jerwah/dell-xps410-j8997-hj485-bay-blanks/PHOTOS.md

# Photos

Back to the [README](README.md).

## The printed parts

Two printed 5.25 inch blanks installed in my XPS 410

Two printed 5.25" blanks installed in my XPS 410.

Two printed 3.5 inch blanks installed: stock on the left, Let it breathe honeycomb on the right

Two printed 3.5" blanks installed: stock on the left, Let it breathe honeycomb (with the more flush face) on the right.

Back view: my printed blank next to the original Dell blank (the one with the sticker), both holding the spare screws

Back view: my print next to the original Dell blank (the one with the sticker), both holding the spare screws.

All three vented blanks: honeycomb and slots installed in the XPS 410 front panel, round holes on the bench

Let it breathe: the honeycomb (top) and slots versions installed in the front panel, the round-hole version on the bench.

## Removing the supports

OrcaSlicer preview of the latch end: keep the latch arms (green), break off the nub under each arm (red) with pliers

Slicer preview of the latch end: keep the latch arms (green), break off the nub under each arm (red).

One pair of needle nose pliers holding the latch arm, a second pair on the nub

One pair of needle nose pliers holding the latch arm, the second pair on the nub.

One nub removed

One nub removed.

Both nubs removed

Both nubs removed.

## The original Dell 5.25" blank (J8997)

These are for shape only; the camera angles make their scale unreliable, so the dimensions in [MEASUREMENTS.md](MEASUREMENTS.md) came from calipers.

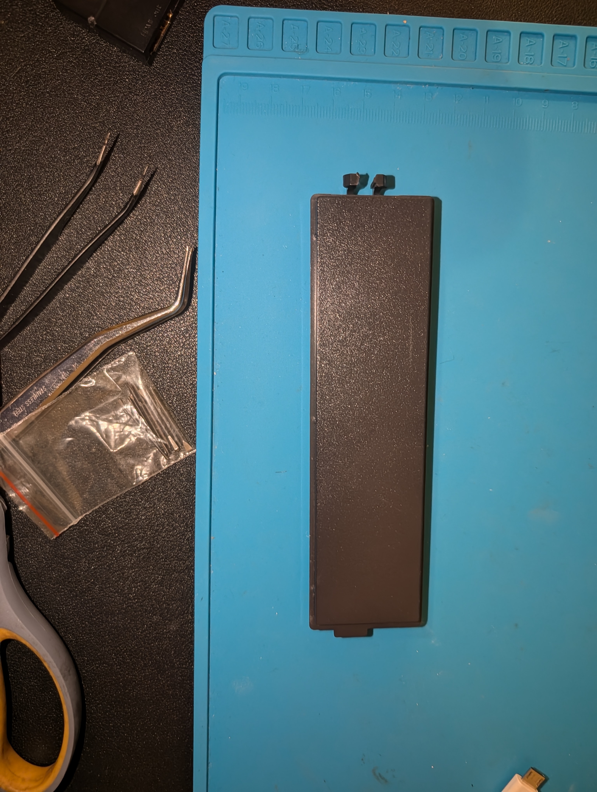
[picture p9: photos/original-front.jpg]
Front face of the original


Front face.

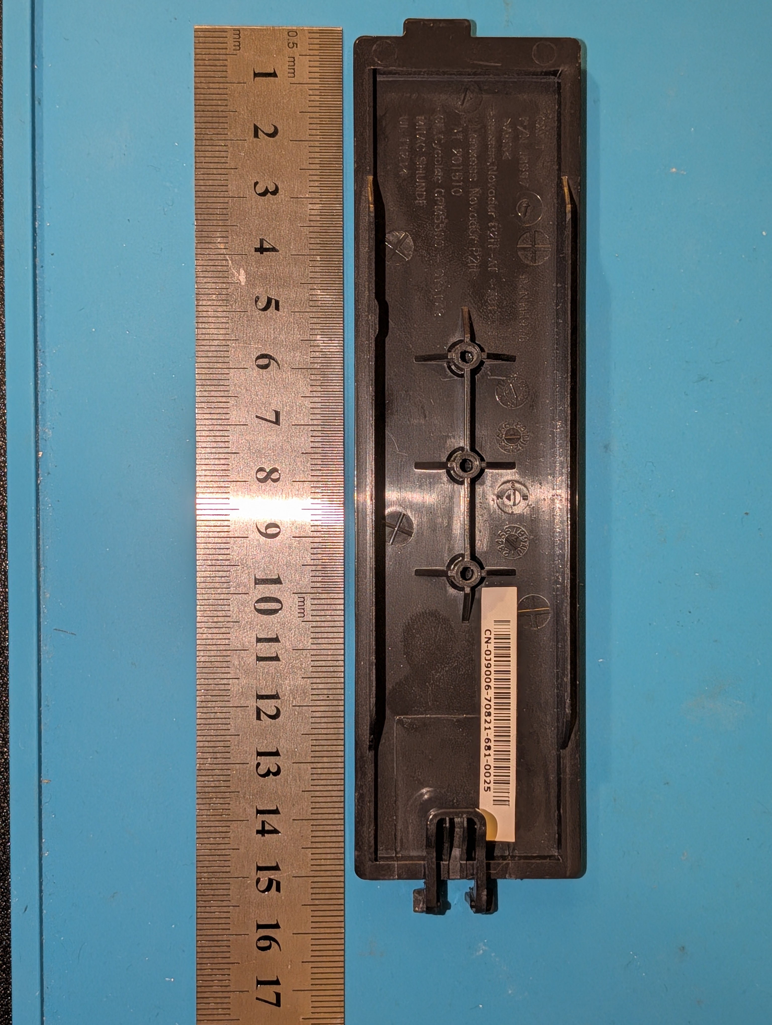
[picture p10: photos/original-back-with-ruler.jpg]
Back of the original with a ruler


Back, with a ruler (best overall view).

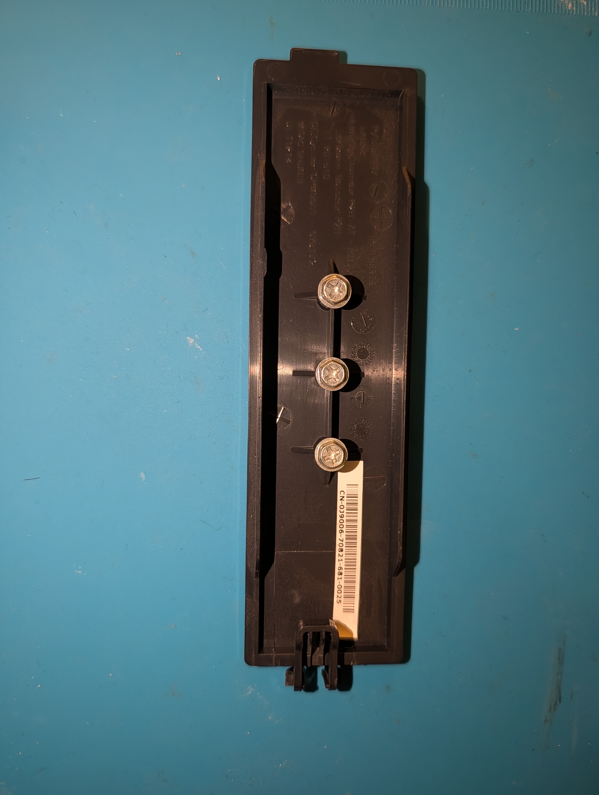
[picture p11: photos/original-back-with-screws.jpg]
Back of the original with the spare screws in the bosses


Back, with the spare screws in the bosses.

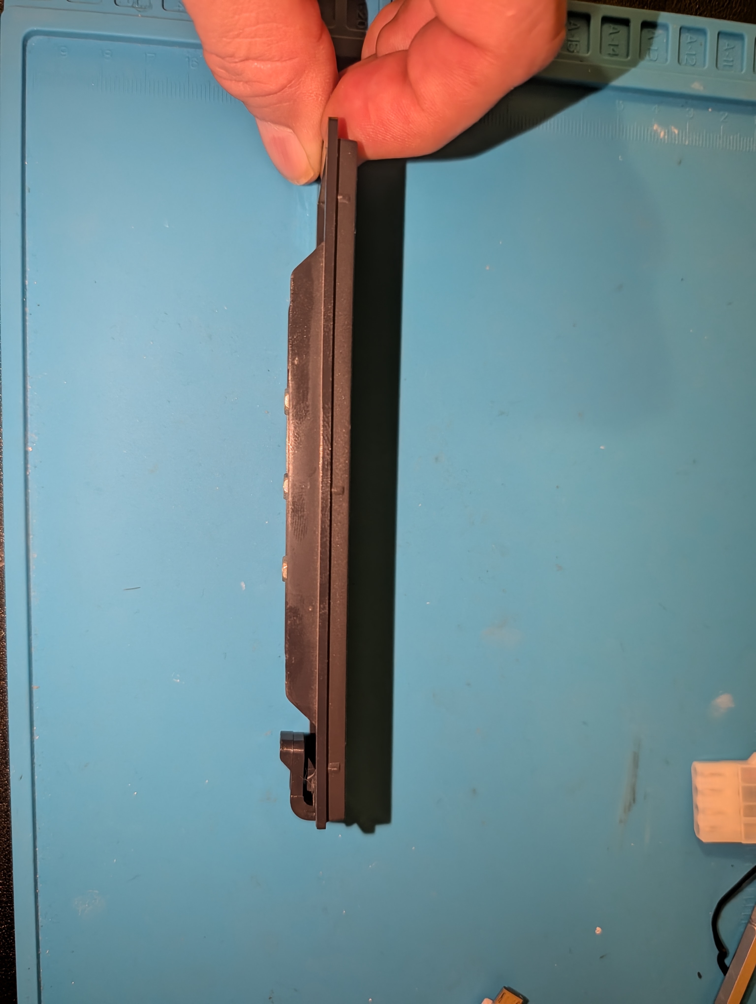
[picture p12: photos/original-side-profile.jpg]
Side profile of the original: rails, ramps and latch


Side profile: rails, ramps and latch.

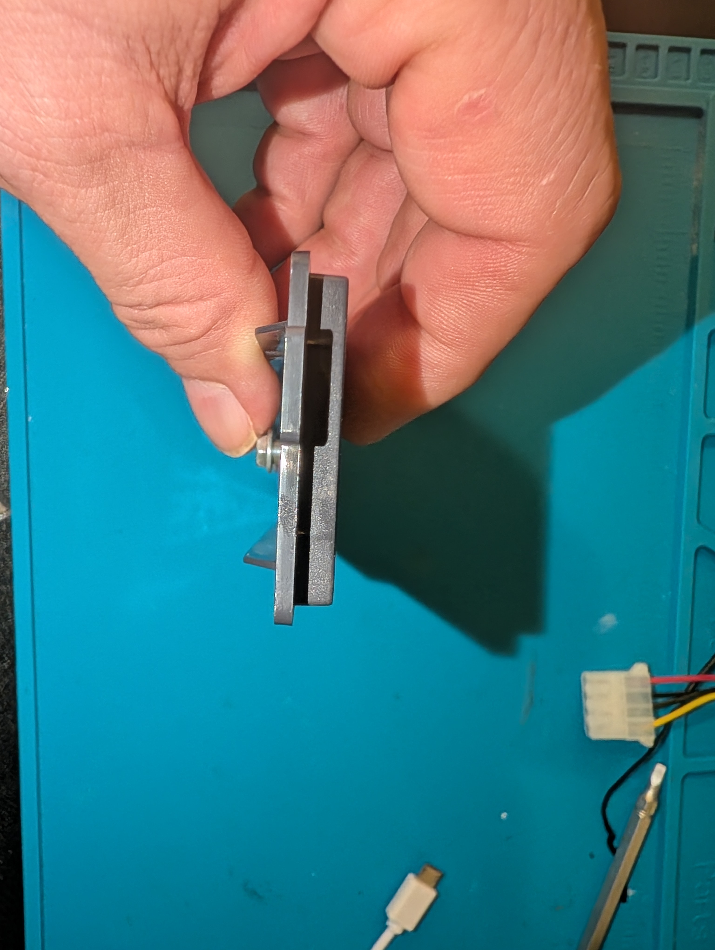
[picture p13: photos/original-end-view.jpg]
End view of the original


End view.

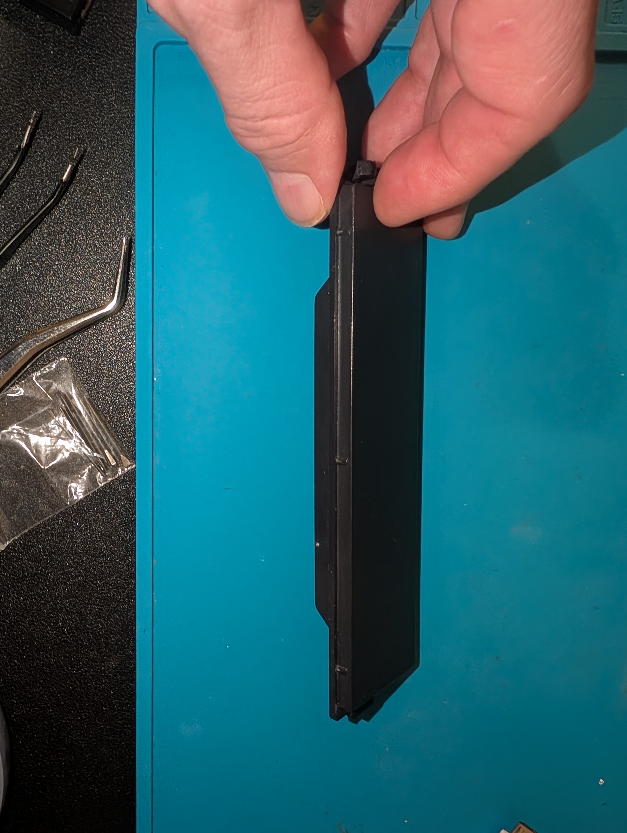
[picture p14: photos/original-edge-crush-nubs.jpg]
Edge view of the original showing the crush nubs


Edge view, showing the crush nubs.

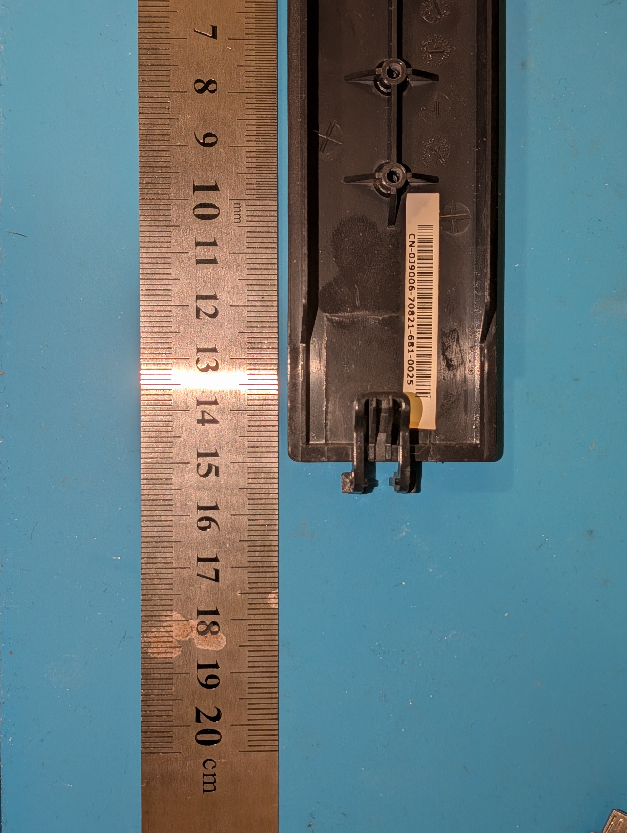
[picture p15: photos/original-latch-back-with-ruler.jpg]
Latch end of the original from the back, with a ruler


Latch end from the back, with a ruler.

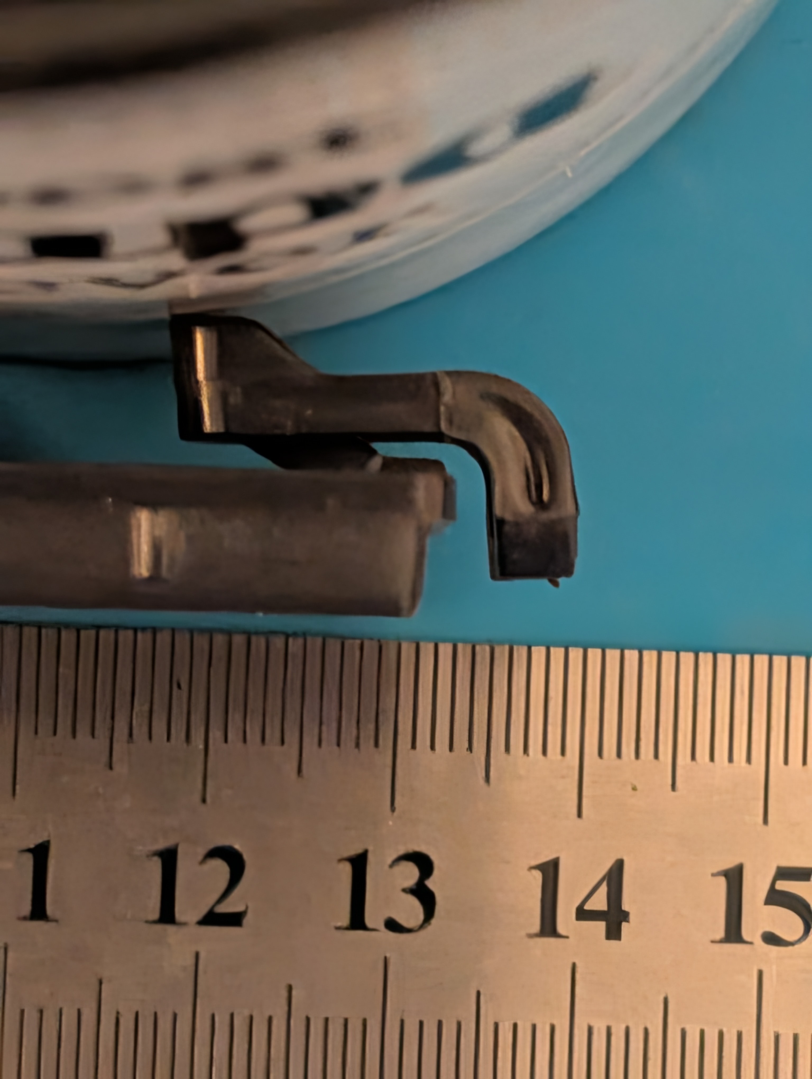
[picture p16: photos/original-latch-side-profile.jpg]
Latch side profile of the original with a ruler


Latch side profile with a ruler (the bend at the end of the arm).

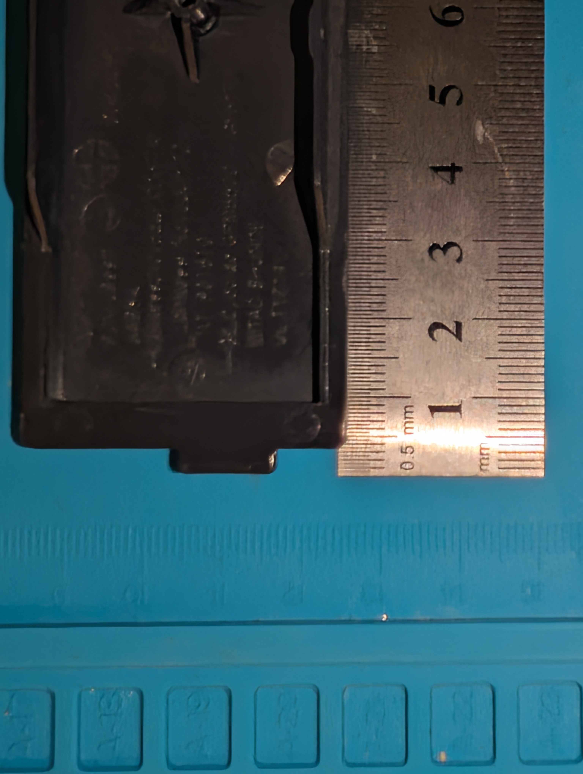
[picture p17: photos/original-tab-closeup.jpg]
Tab close-up of the original with a ruler


Tab close-up with a ruler.

## The original Dell 3.5" blank (HJ485)

As above, for shape only; the dimensions in [MEASUREMENTS-3.5in.md](MEASUREMENTS-3.5in.md) came from calipers.

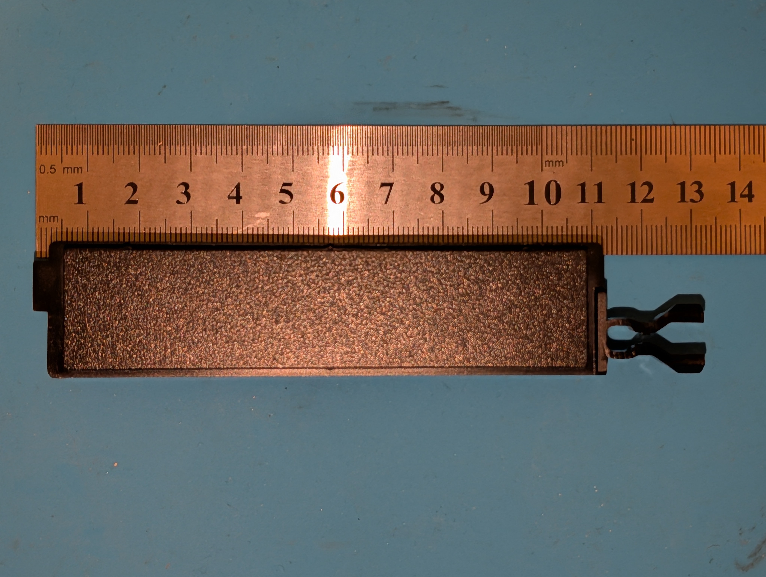
[picture p18: photos/original-3.5-front-with-ruler.jpg]
Front face of the original 3.5 inch blank with a ruler


Front face with a ruler: tab on the left, latch on the right, as installed.

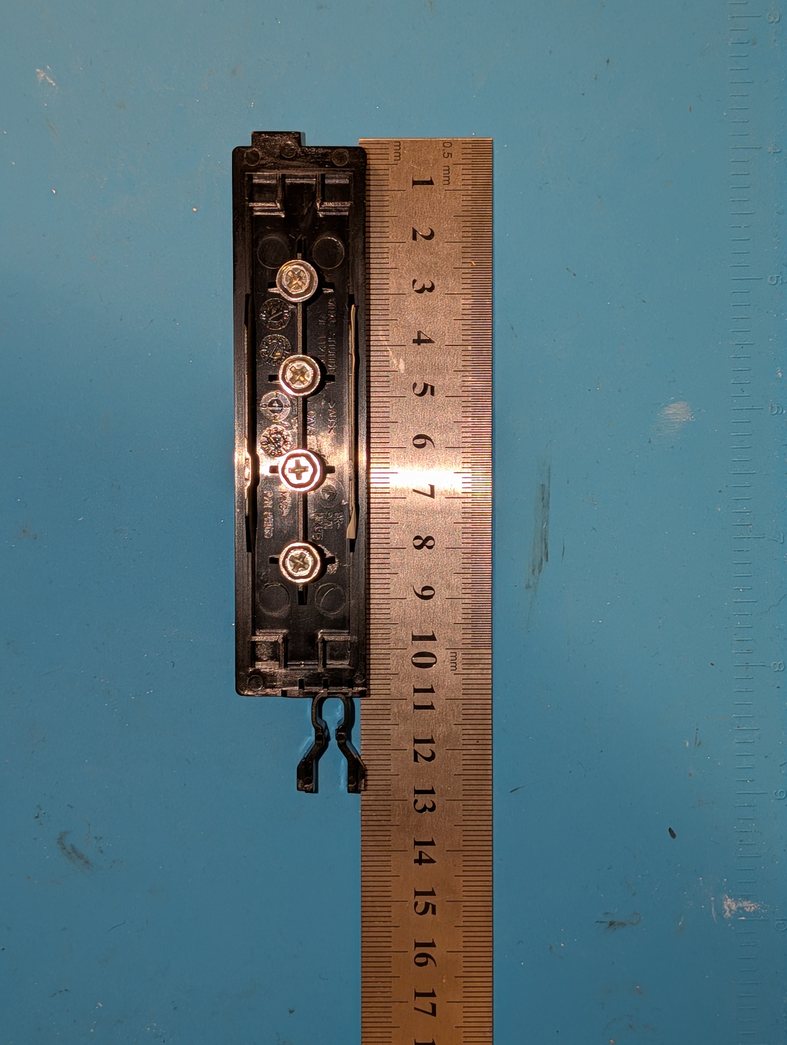
[picture p19: photos/original-3.5-back-with-ruler.jpg]
Back of the original 3.5 inch blank with a ruler


Back, with a ruler (best overall view): pocket, fins, the four screw bosses and the corner boxes.

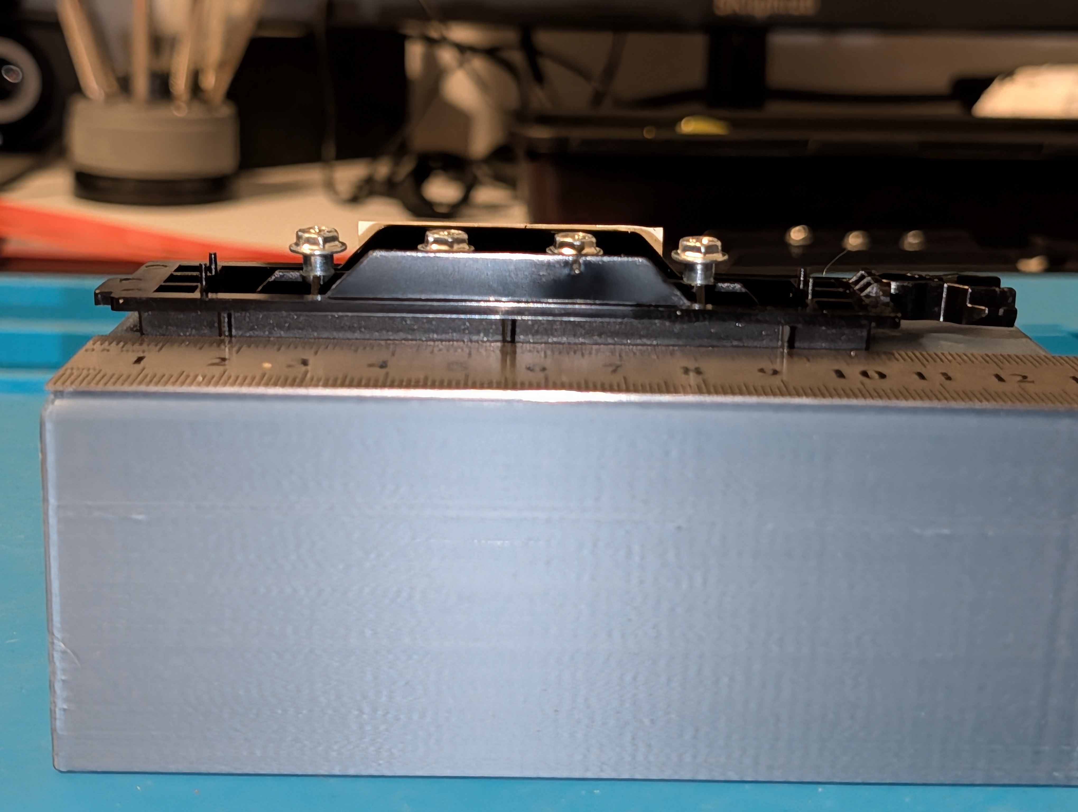
[picture p20: photos/original-3.5-side-profile.jpg]
Side profile of the original 3.5 inch blank


Side profile: the fins and the latch.

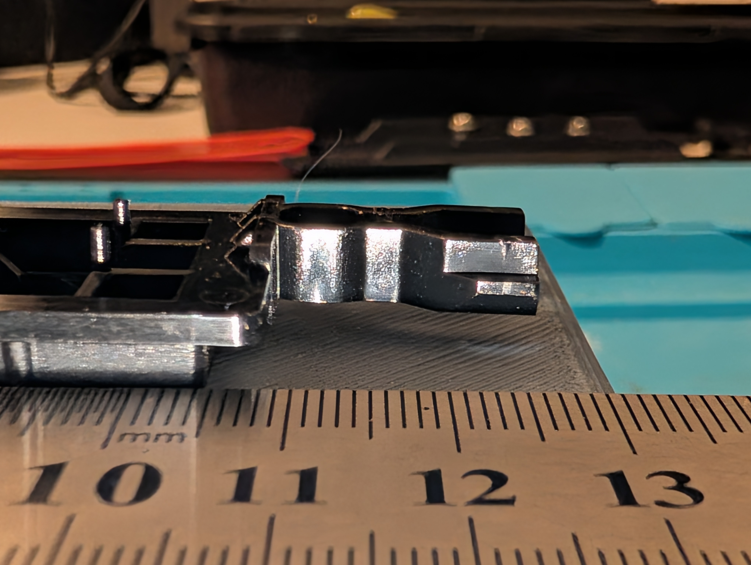
[picture p21: photos/original-3.5-latch-side-closeup.jpg]
Close-up of the original 3.5 inch blank's latch from the side


Latch close-up from the side: the end wall and its braces.

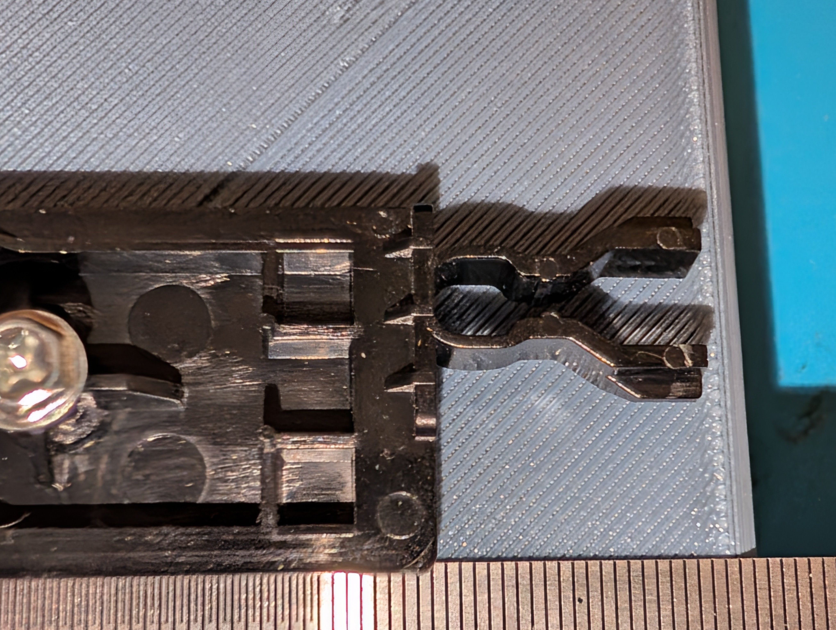
[picture p22: photos/original-3.5-latch-back.jpg]
The original 3.5 inch blank's latch from the back


Latch from the back: the U, the waist, the S-bend and the hooks.

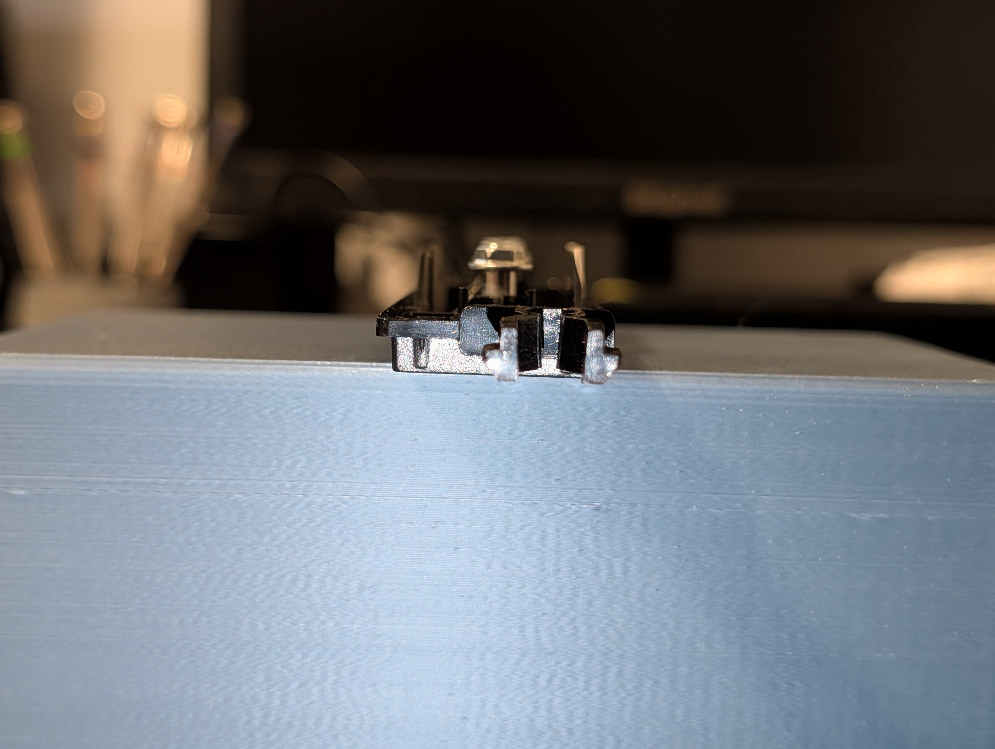
[picture p23: photos/original-3.5-latch-end-view.jpg]
End view of the original 3.5 inch blank's latch, face down


Latch end view, part face down: the hooks' ramps are on the face side.

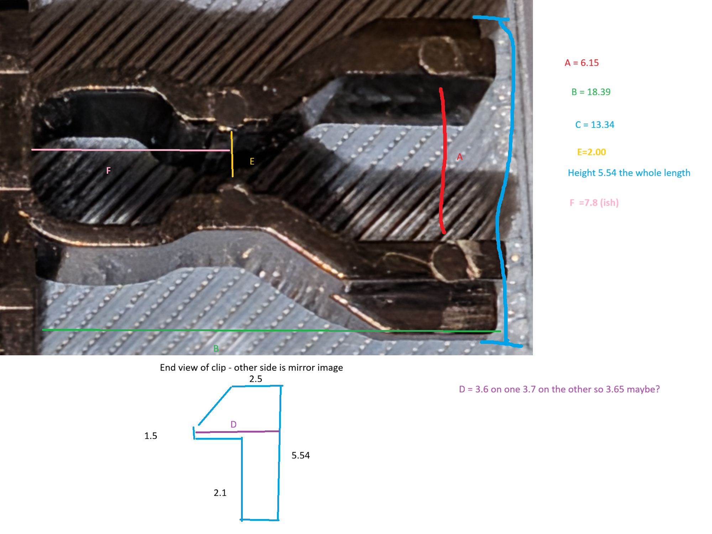
[picture p24: photos/original-3.5-latch-sketch-annotated.png]
My annotated sketch of the 3.5 inch latch


My sketch of the latch with the caliper readings (A to F). The end view sketch is drawn face up, so it's upside down compared with the photo above.

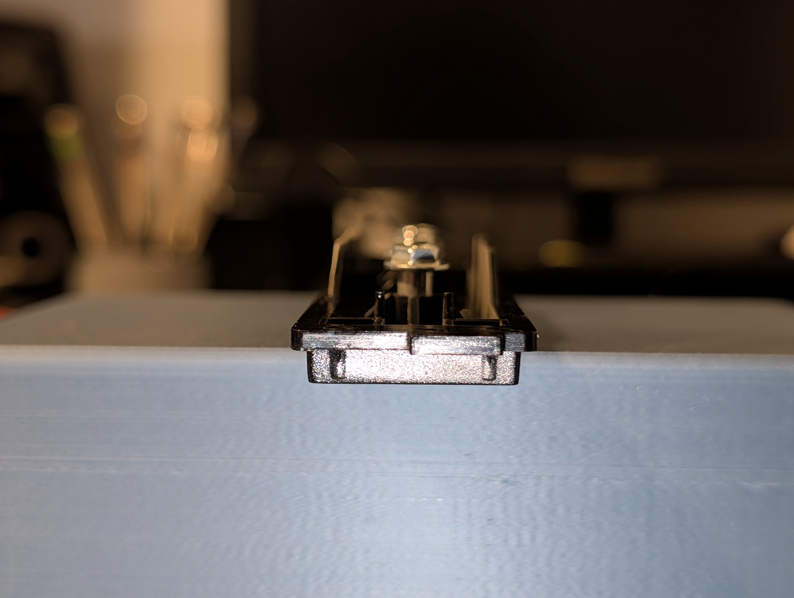
[picture p25: photos/original-3.5-tab-end-view.jpg]
End view of the original 3.5 inch blank at the tab end


Tab end view.

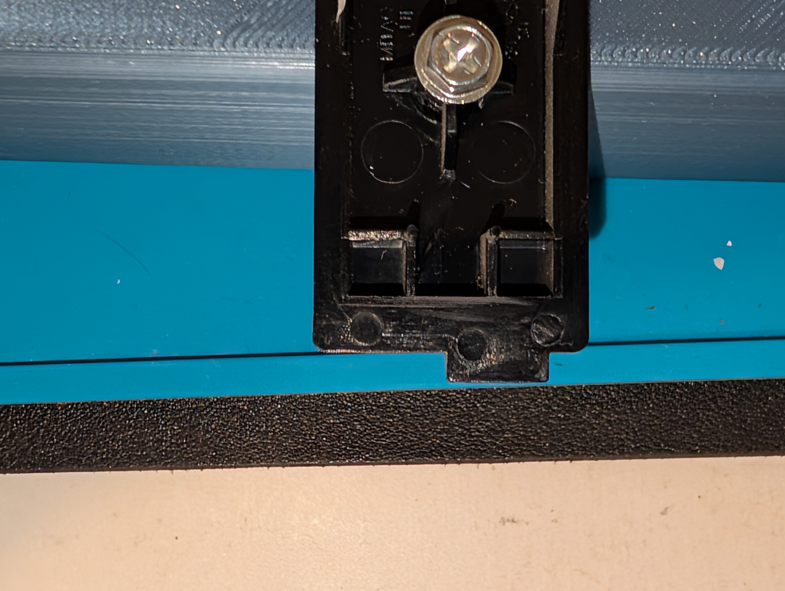
[picture p26: photos/original-3.5-tab-closeup.jpg]
Close-up of the original 3.5 inch blank's tab


Tab close-up.
