jerwah/dell-xps410-j8997-hj485-bay-blanks/stl/test/xps410_3.5_coupon.stl

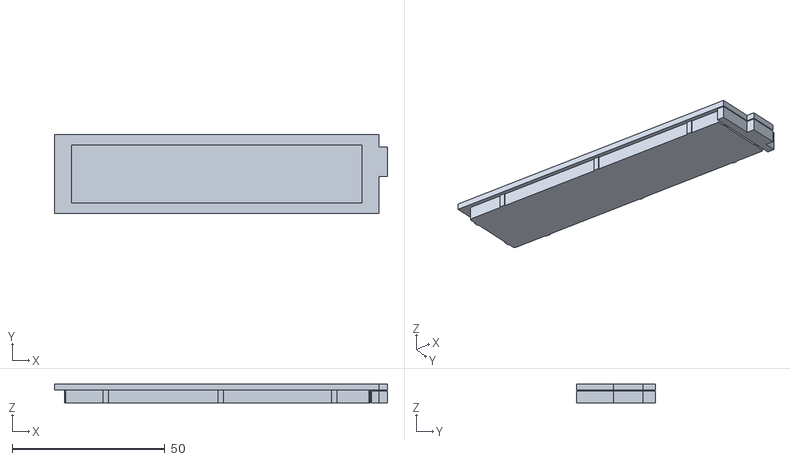
[picture p27: CAD file, 2026-11-12]
stl/test/xps410_3.5_coupon.stl
108.9 x 25.8 x 6.16
