jerwah/dell-xps410-j8997-hj485-bay-blanks/stl/xps410_3.5_bay_blank.stl

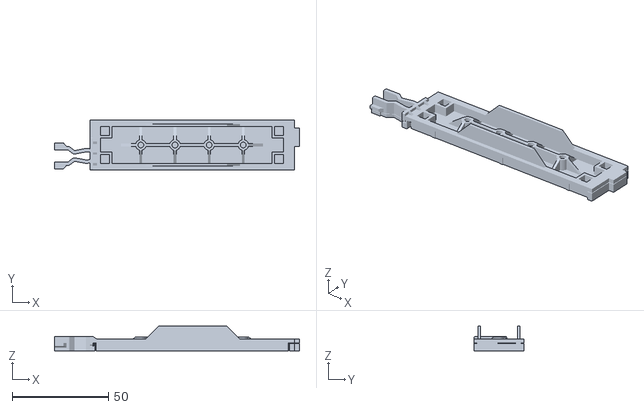
[picture p28: CAD file, 2026-11-12]
stl/xps410_3.5_bay_blank.stl
127.3 x 25.8 x 12.9
