jerwah/dell-xps410-j8997-hj485-bay-blanks/stl/test/xps410_3.5_latch_test.stl

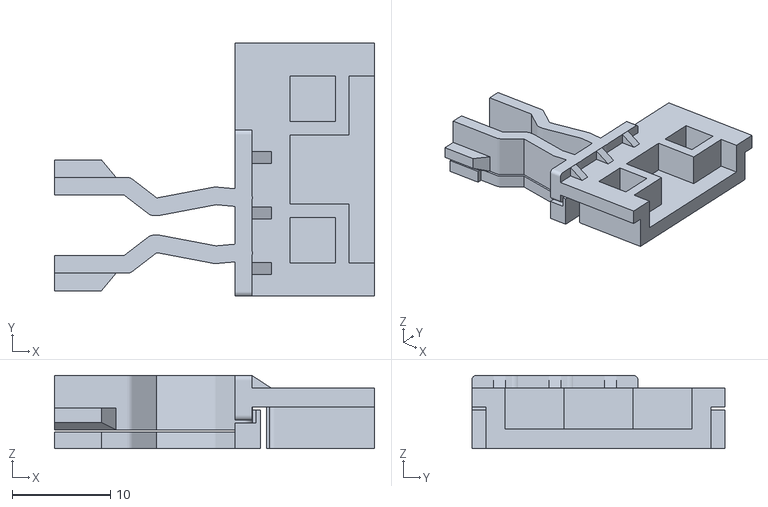
[picture p29: CAD file, 2026-11-12]
stl/test/xps410_3.5_latch_test.stl
32.6 x 25.8 x 7.46
