jerwah/dell-xps410-j8997-hj485-bay-blanks/stl/xps410_3.5_bay_blank_breathe_honeycomb.stl

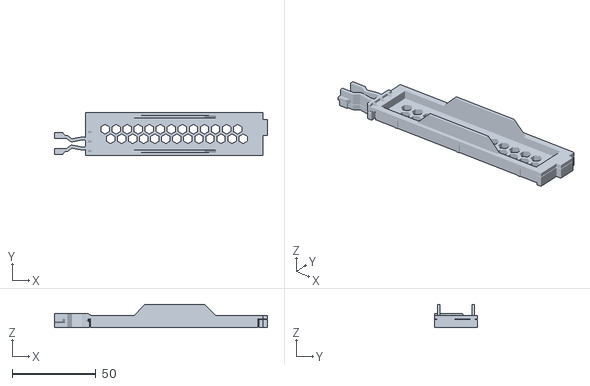
[picture p30: CAD file, 2026-11-12]
stl/xps410_3.5_bay_blank_breathe_honeycomb.stl
127.3 x 25.8 x 13.9
