jerwah/dell-xps410-j8997-hj485-bay-blanks/stl/test/latch_test.stl

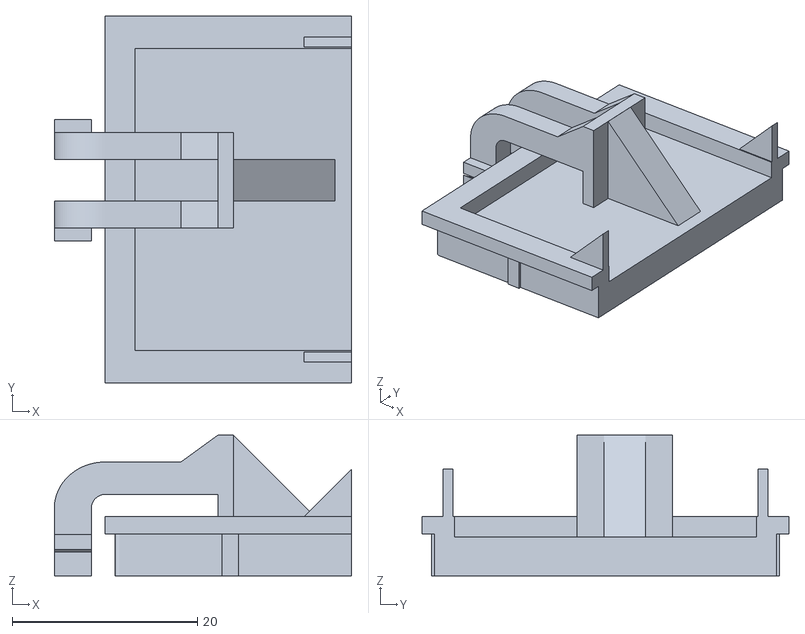
[picture p31: CAD file, 2026-11-11]
stl/test/latch_test.stl
32.1 x 39.6 x 15.2
