jerwah/dell-xps410-j8997-hj485-bay-blanks/stl/test/boss_test.stl

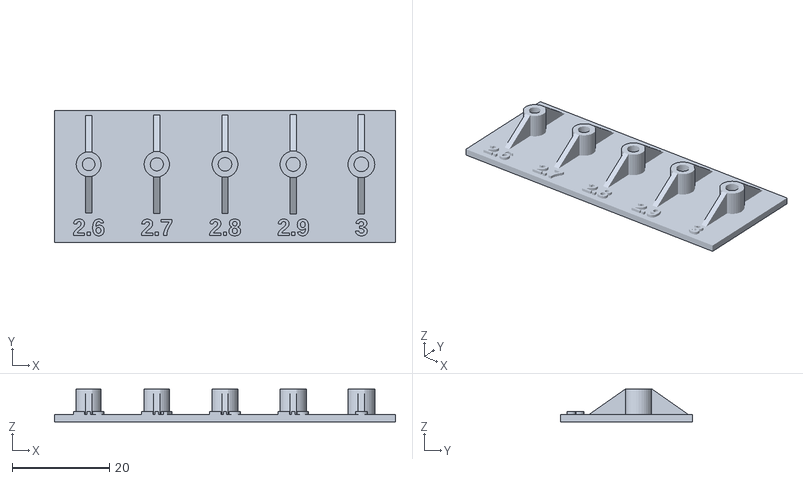
[picture p32: CAD file, 2026-11-11]
stl/test/boss_test.stl
70.0 x 27.0 x 6.76
