jerwah/dell-xps410-j8997-hj485-bay-blanks/stl/xps410_bay_blank_breathe_round.stl

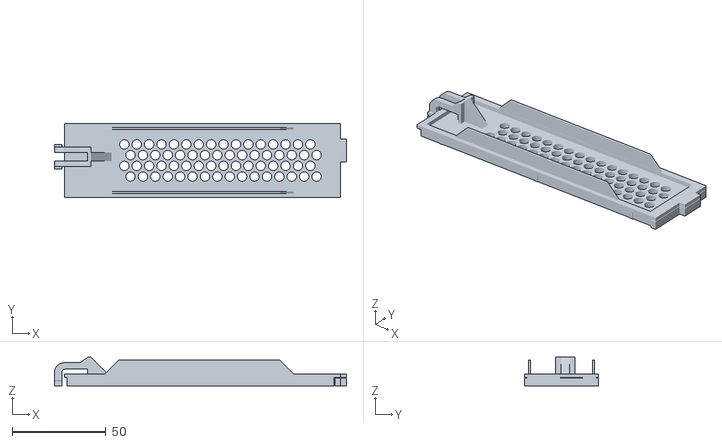
[picture p34: CAD file, 2026-11-12]
stl/xps410_bay_blank_breathe_round.stl
155.4 x 39.6 x 15.2
