jerwah/dell-xps410-j8997-hj485-bay-blanks/stl/xps410_bay_blank.stl

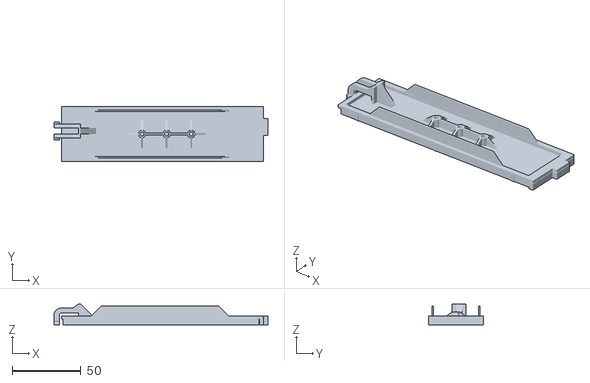
[picture p36: CAD file, 2026-11-11]
stl/xps410_bay_blank.stl
155.4 x 39.6 x 15.2
