jerwah/dell-xps410-j8997-hj485-bay-blanks/(list of files, cad)

Other CAD files:
stl/xps410_3.5_bay_blank_breathe_round.stl
stl/xps410_bay_blank_breathe_honeycomb.stl
