jerwah/dell-xps410-j8997-hj485-bay-blanks/(commit log)

2026-11-11 Dell XPS 410 5.25" drive bay blank (J8997), version 1.0
    Parametric OpenSCAD model of the Dell J8997 / 0J8997 5.25" bay blank
    for the XPS 410 / Dimension 9200, measured from an original part and
    refined over several test prints in PLA and PETG. Includes the final
    STL with built-in breakaway supports, latch and screw-boss test pieces,
    the measurement record, photos, and CC BY-SA 4.0 license.
    AI-assisted: designed with Claude in Claude Code.
    [boss_test.stl, latch_test.stl, xps410_bay_blank.scad, xps410_bay_blank.stl]
2026-11-12 Add Let it breathe vent option
    New let_it_breathe Customizer option (Stock, Round holes, Honeycomb,
    Slots) cuts vents through the pocket floor for airflow when a fan pulls
    air through the drive bays. Any vented choice drops the screw bosses.
    The stock output is unchanged.
    Adds ready-made STLs for all three patterns, a README section with a
    photo of the tested prints, Customizing rows, a MEASUREMENTS table for
    the vent dimensions, and fixes the stale test log mention in the Files
    table.
    [xps410_bay_blank.scad, xps410_bay_blank_breathe_honeycomb.stl, xps410_bay_blank_breathe_round.stl, xps410_bay_blank_breathe_slots.stl]
2026-11-12 Add the 3.5" bay blank (HJ485), version 1.0
    New parametric model of the XPS 410's 3.5" bay blank (Dell HJ485 /
    P8106, DP/N 0KJ293), measured from an original and test printed in
    PETG: two latch tests, two face coupons, and stock and honeycomb full
    blanks, both fitting and latching like the original.
    - Same layout as the 5.25" blank: built-in breakaway supports, crush
    nubs, four spare-screw bosses, and the Let it breathe vent options
    (vented versions also drop the corner boxes).
    - New more_flush option: the original sits about 1 mm inset in the
    front panel; this makes the face 1 mm deeper. Off for stock, on by
    default when the blank breathes.
    - STLs for the stock blank, the three ven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
    [xps410_3.5_bay_blank.scad, xps410_3.5_bay_blank.stl, xps410_3.5_bay_blank_breathe_honeycomb.stl, xps410_3.5_bay_blank_breathe_round.stl, xps410_3.5_bay_blank_breathe_slots.stl, xps410_3.5_coupon.stl, xps410_3.5_latch_test.stl, xps410_bay_blank.scad]
